Prof-Syaef/ExFaBox_IoT/README.md

# ExFaBox_IoT
Perangkat sistem monitoring temperature dan humidity yang memiliki data logger menggunakan MicroSD serta dapat melakukan action untuk menjaga temperature dan humidity menggunakan fan dengan 2 swtihing relay.
