Prof-Syaef/ExFaBox_IoT/ExFaBox_V1/Eksport skematik EDUTIC_SMART_MONITORING_IOT_V1.0.pdf

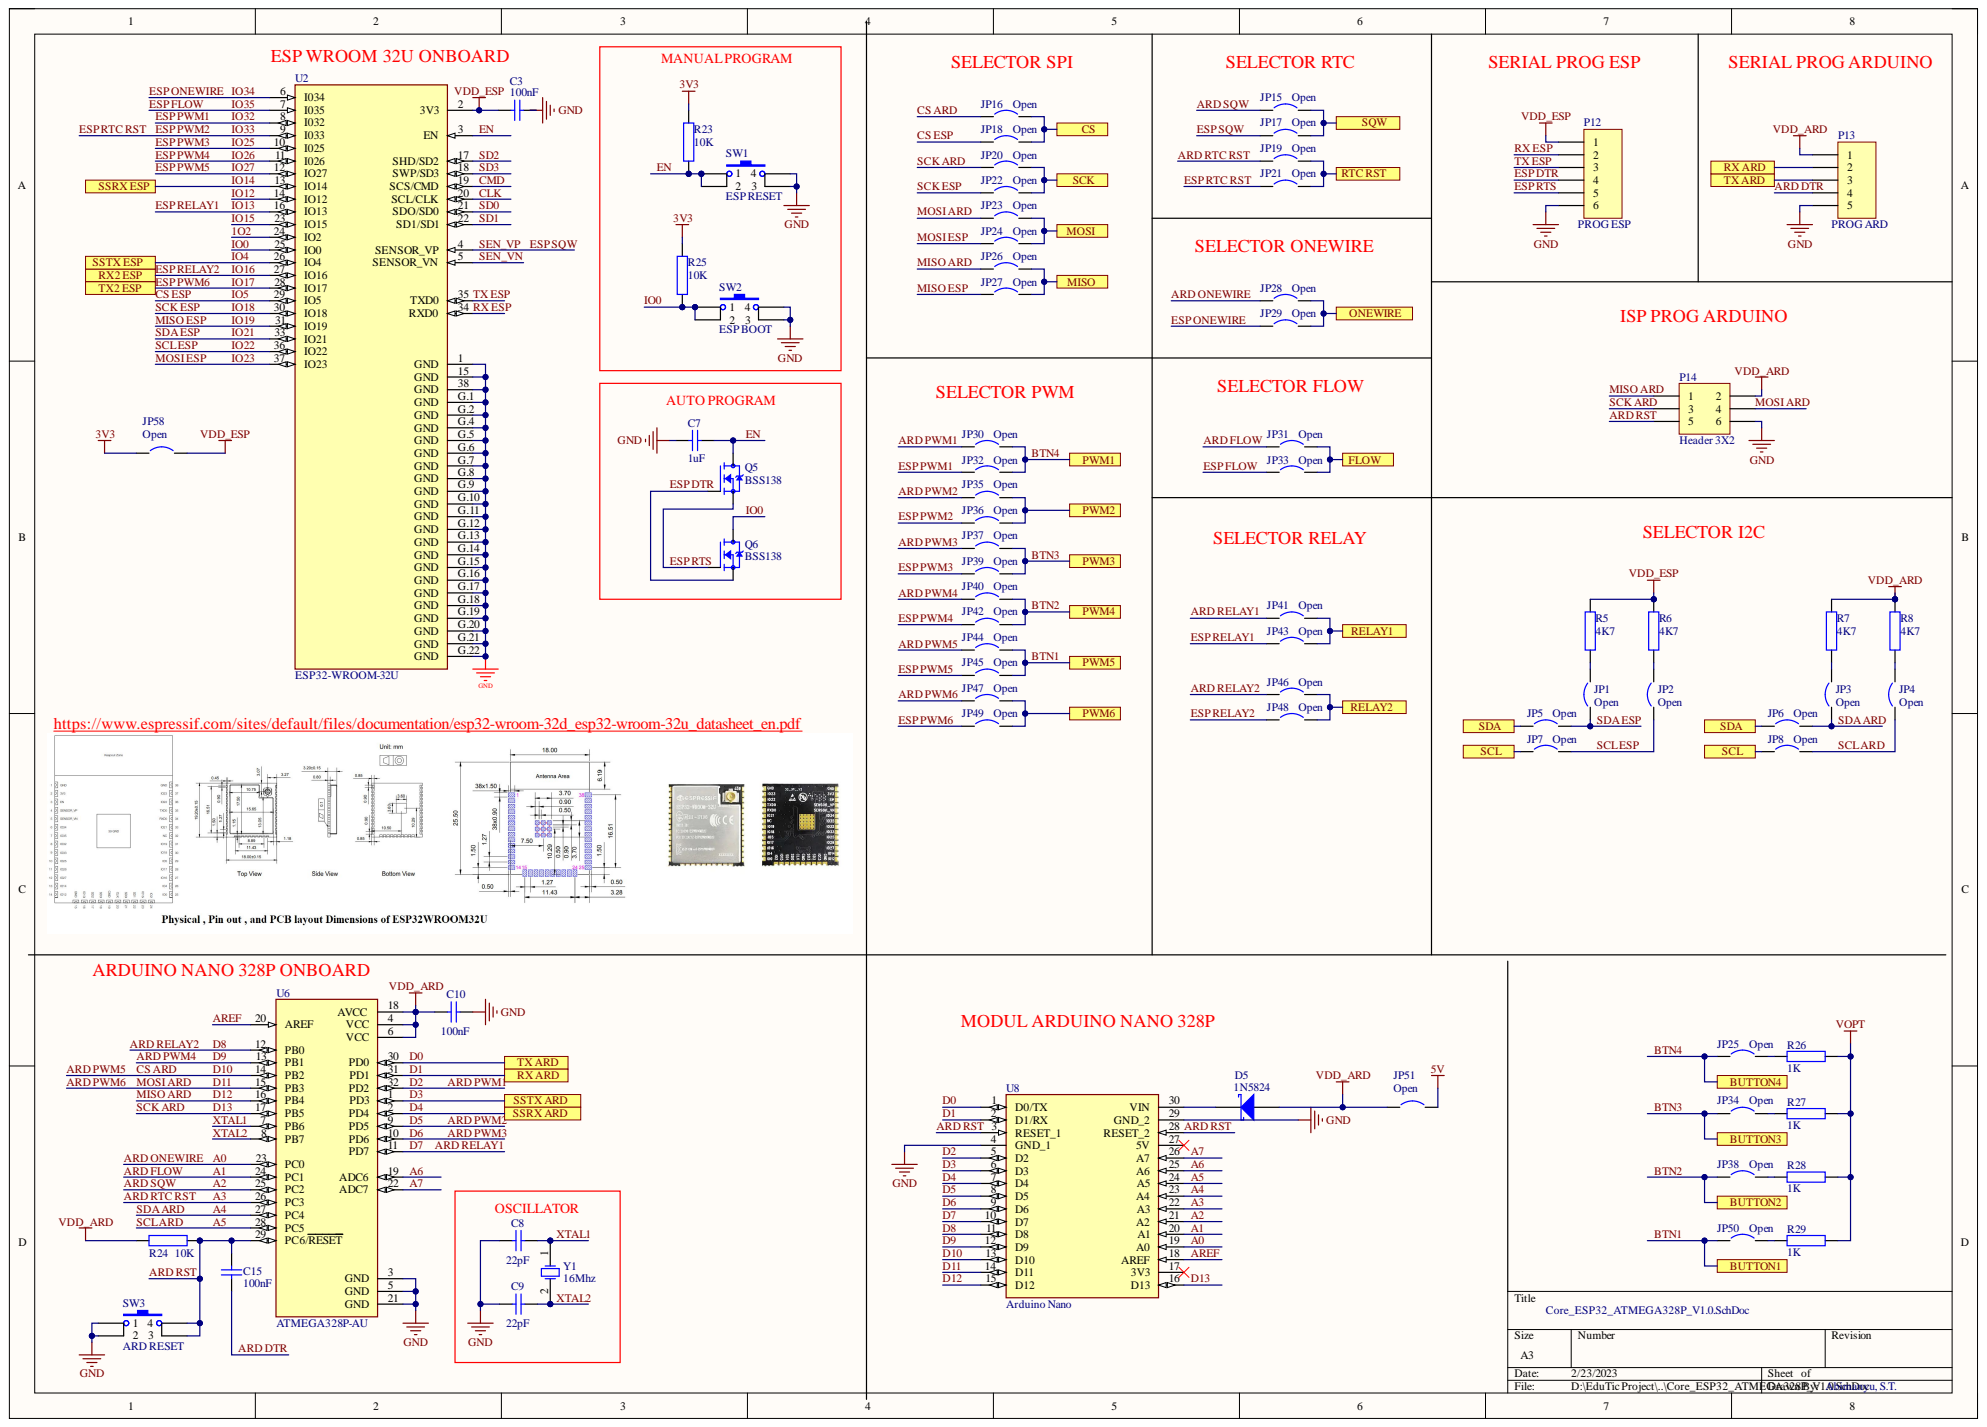
[picture p1: page 1]

RX2 ESP | ESPRELAY2 IO16 | IO16 27 | TX ESP

https://www.espressif.com/sites/default/files/documentation/esp32-wroom-32d_esp32-wroom-32u_datasheet_en.pdf

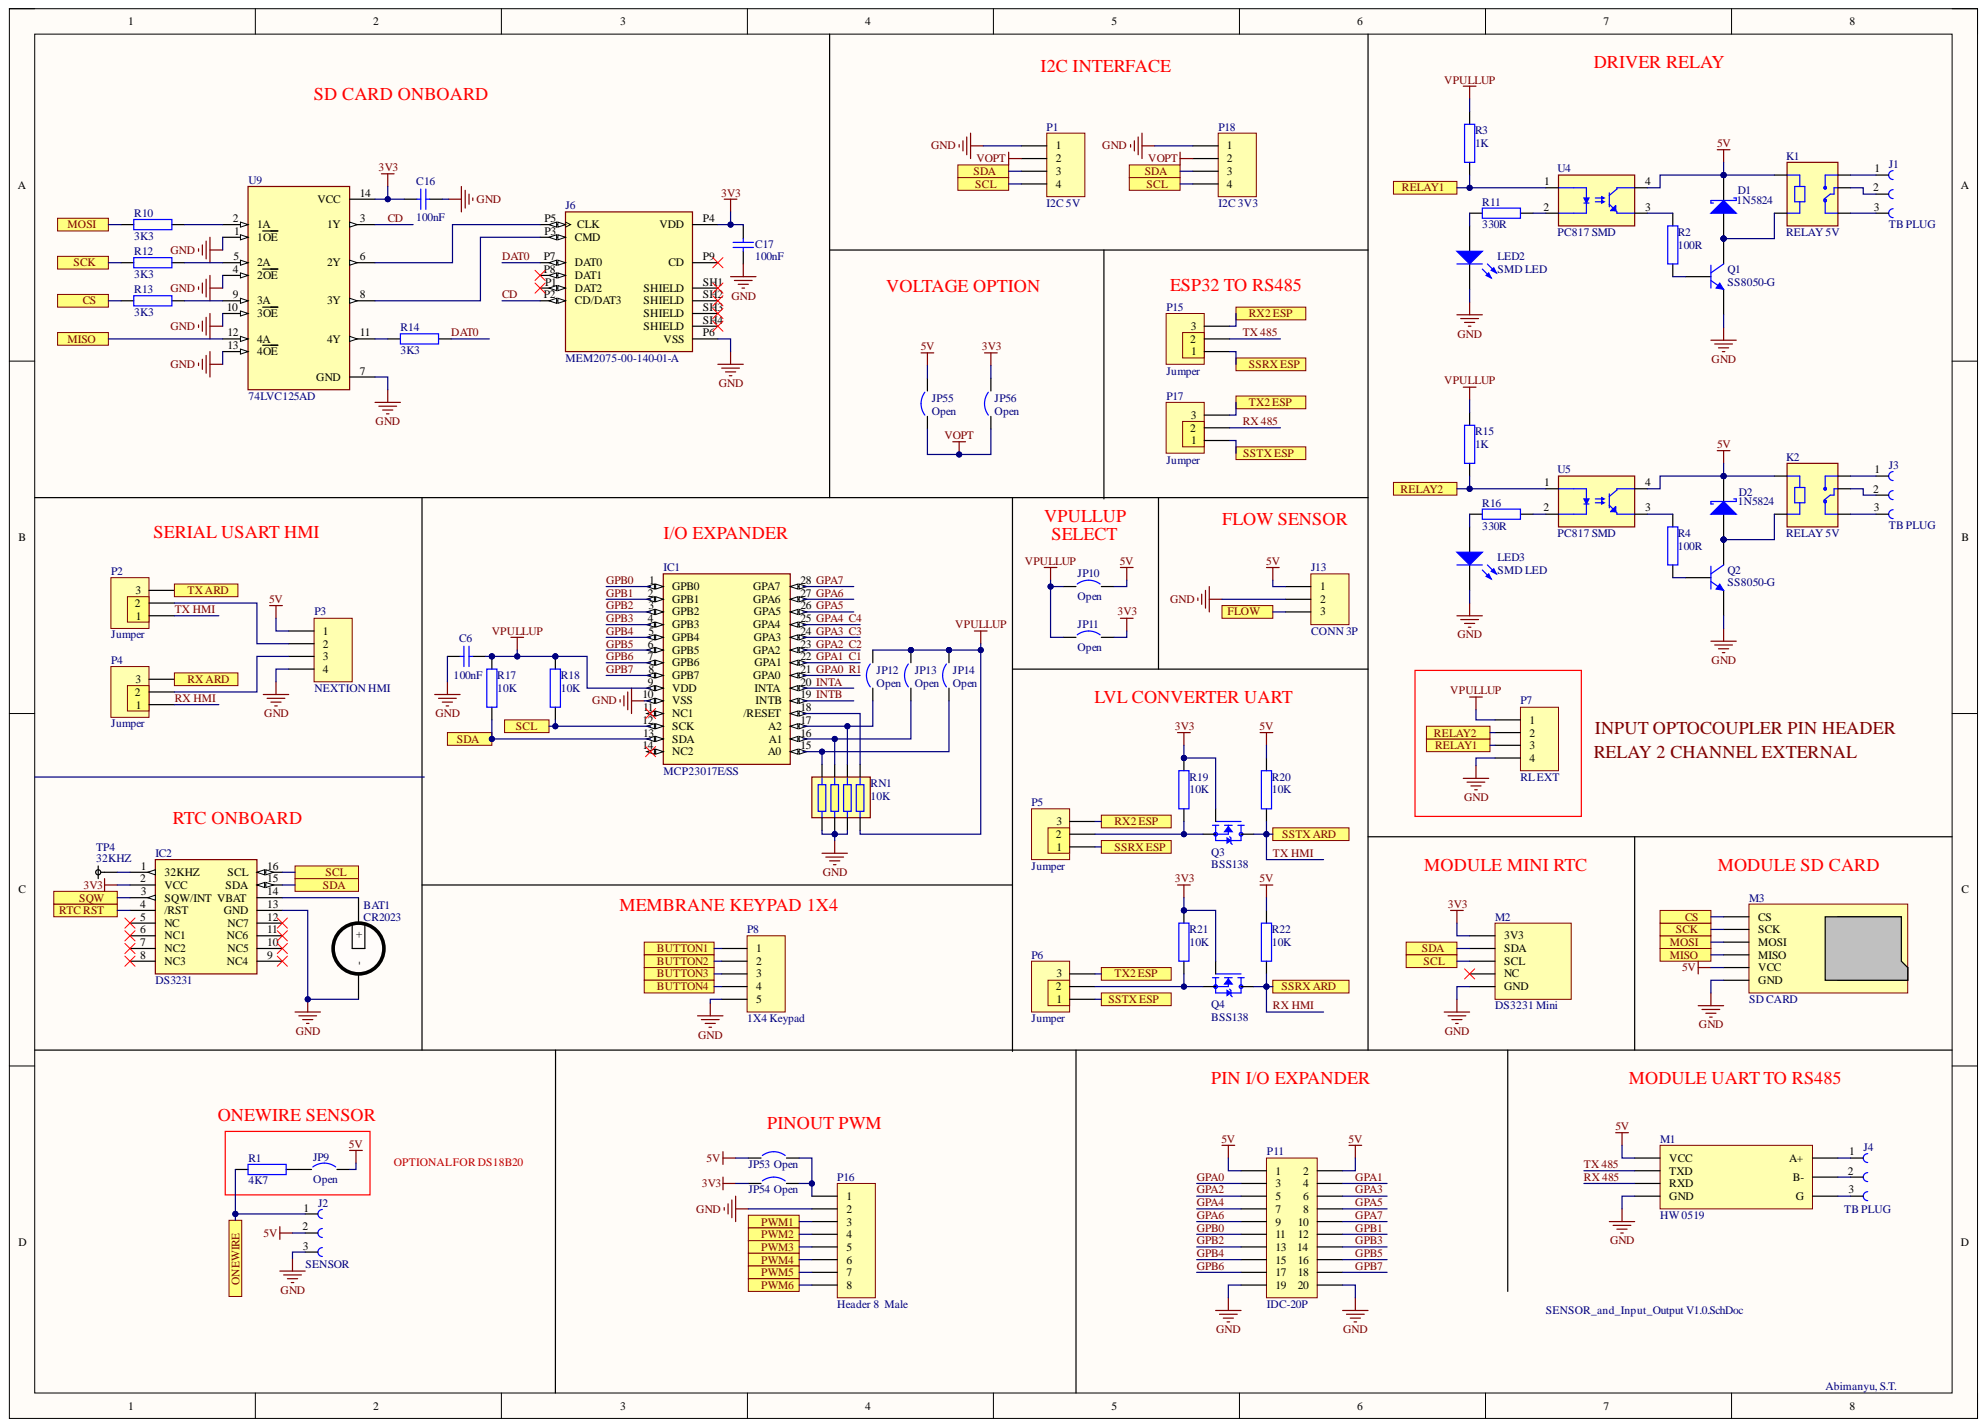
[picture p2: page 2]

2 1 | 3V3 | | SSTX ARD

SSRX ESP | BSS138 | TX HMI

SQW | /RST 4

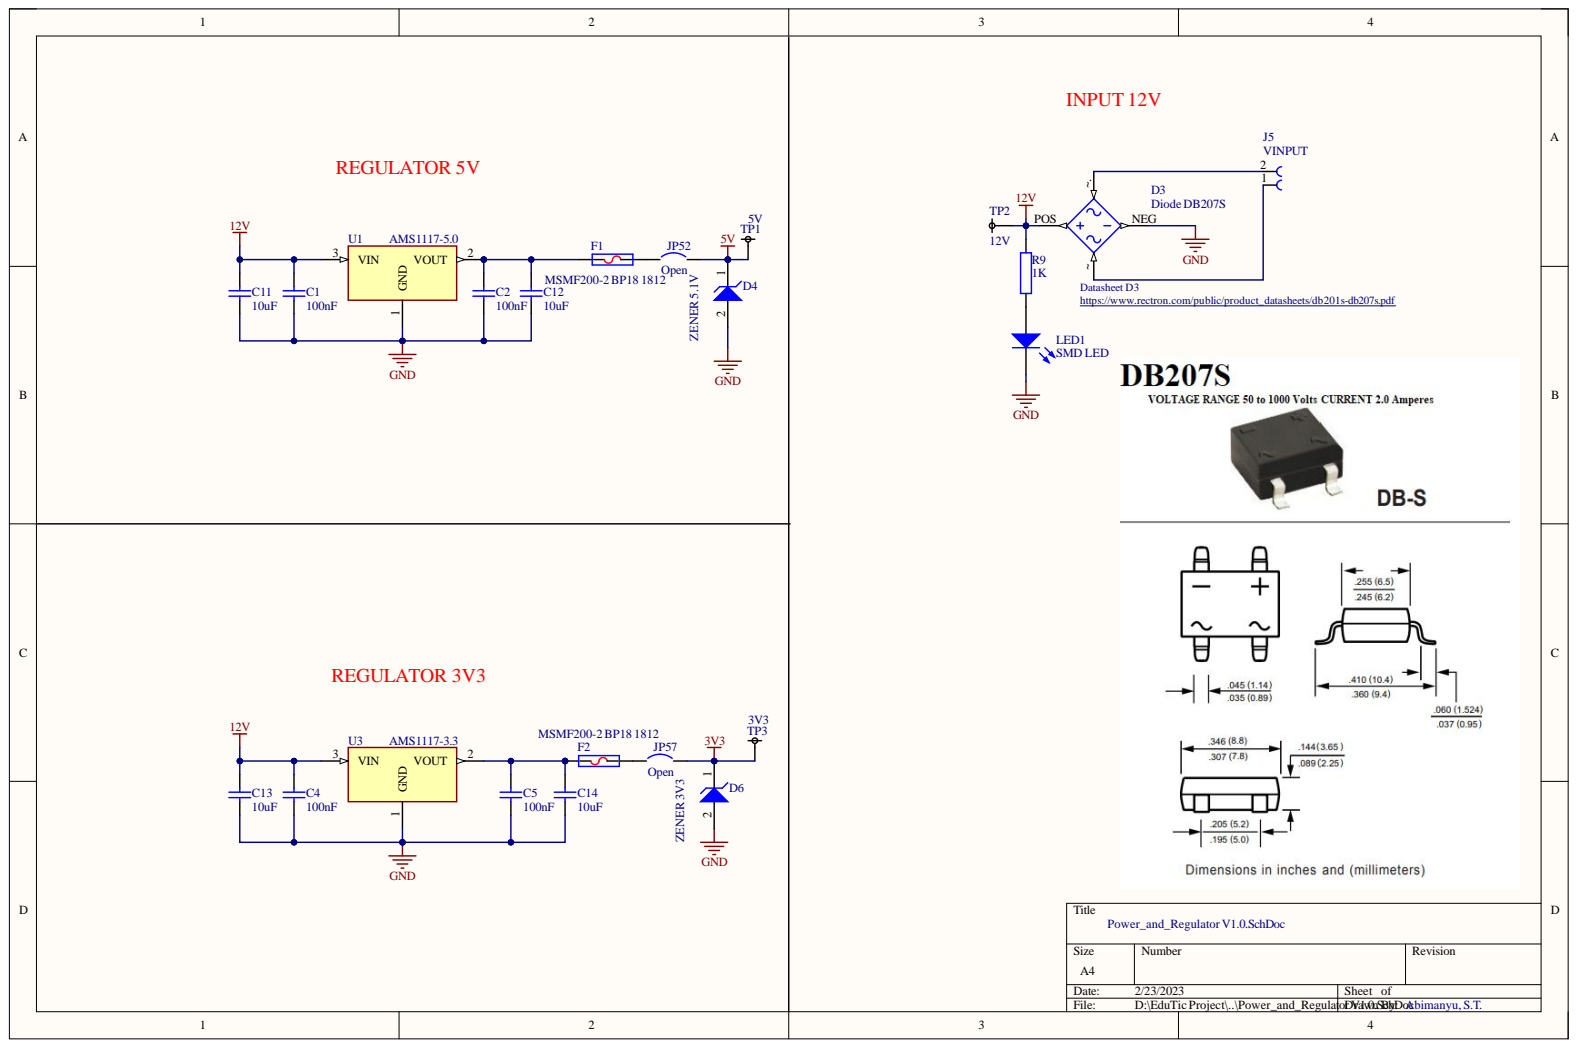
[picture p3: page 3]

https://www.rectron.com/public/product_datasheets/db201s-db207s.pdf

Size A4 | Number | Revision

Date: 2/23/2023 | Sheet of
File: D:\EduTic Project\..\Power_and_RegulatoDr r Va1wn .0.SBchy:Doc | Abimanyu, S.T.

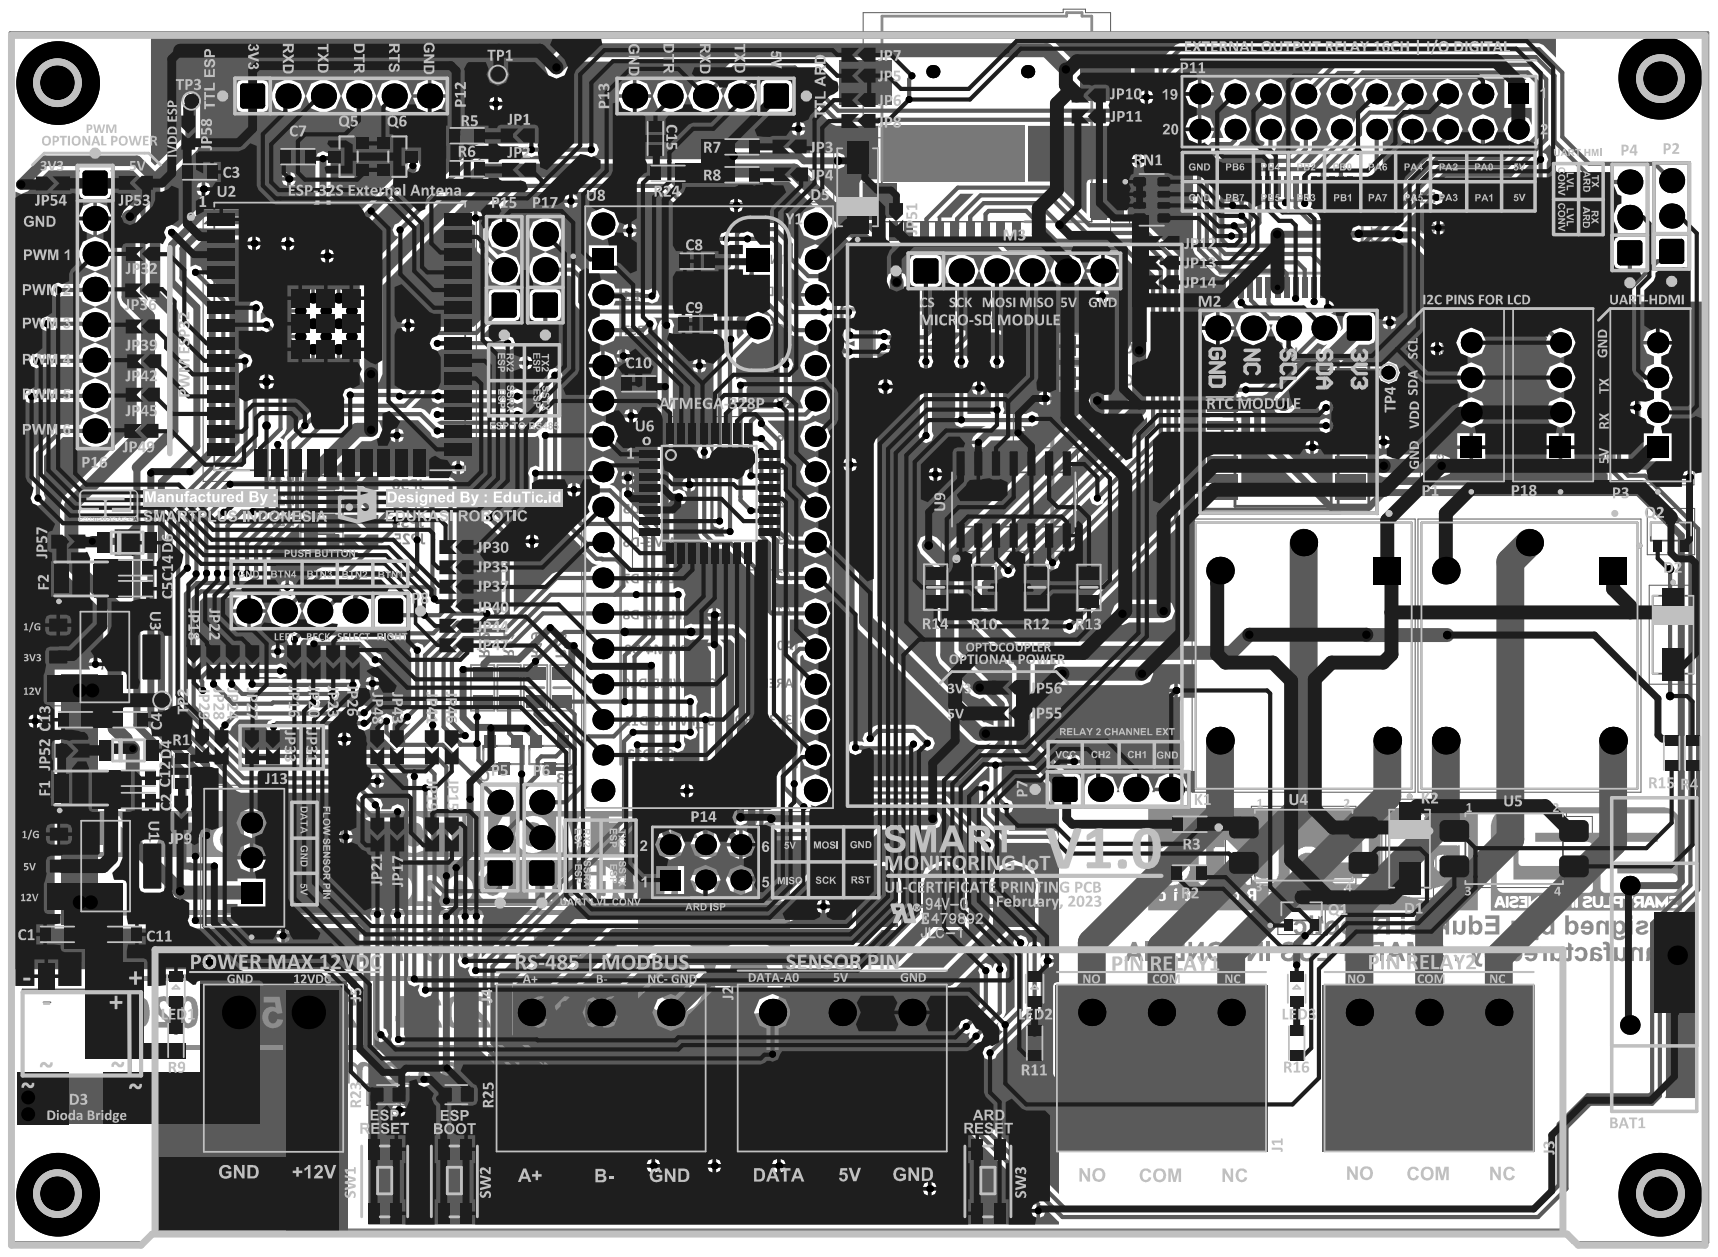
[picture p4: page 4]

Comment | Description | Designator | Footprint | LibRef | Quantity
CR2023 | BATTERY HOLDER | BAT1 | BATT CR2023
| | | VERTICAL | BATT CR2023
VERTICAL | 1
100nF | 0805 SMD Non-Polarity Capacitor, 1206 SMD Non-Polarity Capacitor | C1, C2, C3, C4, C5, C10, C15 | 1608_[0603] Capacitor | Capacitor 0805 (Inch), Capacitor 1206 (Inch) | | 7
100nF | 0805 SMD Non-Polarity Capacitor | C6, C16, C17 | CAP-0805_Capacitor Non Polar | Capacitor 0805 (Inch) | | 3
1uF | 0805 SMD Non-Polarity Capacitor | C7 | 1608_[0603] Capacitor | Capacitor 0805 (Inch) | | 1
22pF | 1206 SMD Non-Polarity Capacitor | C8, C9 | 1608_[0603] Capacitor | Capacitor 1206 (Inch) | | 2
10uF | 0805 SMD Non-Polarity Capacitor | C11, C12, C13, C14 | 1608_[0603] Capacitor | Capacitor 0805 (Inch) | | 4
1N5824 | Maximum repetitive peak reverse voltage 40v Maximum average forward rectified current 5.0A Peak forward surge current 8.3mS 100A Voltage rate of change 10000 V/uS Operating junction temperature range -55 to +150 C | D1, D2, D5 | DO-214AC | 1N5824 SMD | | 3
Diode DB207S | Bridge Rectifier Single Phase Standard 1kV 2A Surface Mount DB-S | D3 | SOP 4 - Dioda Bridge -duplicate | Diode DB207S | | 1
ZENER 5.1V | Zener Diodes 4.7V 200mW | D4 | SOD-80C | Diode Zener 2 | | 1
ZENER 3V3 | Zener Diodes 4.7V 200mW | D6 | SOD-80C | Diode Zener 2 | | 1
1210 | PTC RESET FUSE 8V 2A | F1, F2 | 1206_Fuse | PTC RESET FUSE | | 2
MCP23017E/SS | I/O Expander 16 IÂ²C 10MHz 28-SSOP | IC1 | SSOP-28 | MCP23017E/SS | | 1
DS3231 | Real Time Clock (RTC) IC Clock/Calendar -IÂ²C, 2-Wire Serial 8-SOIC (0.154, 3.90mm Width) | IC2 | SOIC-16 | DS3231 | | 1
TB PLUG | TB PLUG 3P 5M | J1, J3, J4 | TB PLUG 3P 5mm | TB PLUG 3P 5M | | 3
SENSOR | TB PLUG 3P 5M | J2 | TB PLUG 3P 5mm | TB PLUG 3P 5M | | 1
VINPUT | 2 Position Terminal Block Header, Male Pins, Shrouded (2 Side) 0.197 (5.00mm) 90Â°, Right Angle -Through Hole | J5 | TERMINAL BLOCK PLUG 2P 5MM | TERMINAL BLOCK PLUG 2P 5MM | | 1
MEM2075-00-140-01-A | Micro SD Memory Card Connector, 1.4mm Profile SMT, Push-Push, with Normally open Switch | J6 | GCT_MEM2075-00-140-01-A | MEM2075-00-140-01-A | | 1
CONN 3P | Connector Header Through Hole 3 position 0.098 (2.50mm) | J13 | CONN HDR 3P TH | CONN HDR 3P TH | | 1
Open | Jumper Solder Pad | JP1, JP2, JP3, JP4, JP5, JP6, JP7, JP8, JP9, JP10, JP11, JP12, JP13, JP14, JP15, JP16, JP17, JP18, JP19, JP20, JP21, JP22, JP23, JP24, JP25, JP26, JP27, JP28, JP29, JP30, JP31, JP32, JP33, JP34, JP35, JP36, JP37, JP38, JP39, JP40, JP41, JP42, JP43, JP44, JP45, JP46, JP47, JP48, JP49, JP50, JP51, JP52, JP53, JP54, JP55, JP56, JP57, JP58 | SB_STM | Jumper Solder | 58
RELAY 5V | 5V Trigger Relay Module For Arduino And Raspberry Pi 5V Trigger Relay Module For Arduino And Raspberry Pi | K1, K2 | RELAY_SONGLE-05VDC-SL-C | RELAY SONGLE 5V | | 2
SMD LED | 0603 RED LED, 0603 BLUE LED | LED1, LED2, LED3 | LED SMT 1608 (0603) | LED SMT RED, LED SMT BLUE | | 3
HW 0519 | RS485 TO UART | M1 | HW 0519 | HW 0519 | | 1
DS3231 Mini | Mini RTC | M2 | Module DS3231 Mini RTC RIVERSED | Module RIVERSED DS3231 Mini RTC for Pi | | 1
SD CARD | Module SD CARD | M3 | MODULE SD CARD | Module SD CARD | | 1
I2C 5V | CONN HEADER 4P TH | P1 | CONN HDR 4P TH | CONN HDR 4P TH | | 1
Jumper | Jumper Pin, 3-Pin | P2, P4, P5, P6, P15, P17 | Jumper Pin, 3-Pin | Jumper Pin, 3-Pin | | 6
NEXTION HMI | CONN HEADER 4P TH | P3 | CONN HDR 4P TH | CONN HDR 4P TH | | 1
RL EXT | Header, 4-Pin | P7 | Pin Header 1x4 TH Pitch 2.54mm | Header 4 Male | | 1
1X4 Keypad | Header, 5-Pin | P8 | Pin Header 1x5 TH Pitch 2.54mm | Header 5 Male | | 1
IDC-20P | IDC-20P | P11 | IDC-20P | IDC-20P | | 1
PROG ESP | Header, 6-Pin | P12 | Pin Header 1x6 TH Pitch 2.54mm | Header 6 Male | | 1
PROG ARD | Header, 5-Pin | P13 | Pin Header 1x5 TH Pitch 2.54mm | Header 5 Male | | 1
Header 3X2 | Header, 3-Pin, Dual row | P14 | HEADER 2X3 | Header 3X2 | | 1
Header 8 Male | Header, 8-Pin | P16 | Pin Header 1x8 TH Pitch 2.54mm | Header 8 Male | | 1
I2C 3V3 | CONN HEADER 4P TH | P18 | CONN HDR 4P TH | CONN HDR 4P TH | | 1
SS8050-G | Bipolar (BJT) Transistor NPN 25 V 1.5 A 100MHz 300mW Surface Mount SOT-23-3 | Q1, Q2 | TO-236 | TR SS8050-G | | 2
BSS138 | N-CH MOSFET 50V 0.34A SOT-23-3L | Q3, Q4, Q5, Q6 | SOT-23 | BSS138 | | 4
4K7 | 0805 SMD Thick Resistor, 1206 SMD Thick Resistor | R1, R5, R6, R7, R8 | 1608_[0603] Resistor | Resistor 0805 (Inch), Resistor 1206 (Inch) | | 5
100R | 1206 SMD Thick Resistor | R2, R4 | 1608_[0603] Resistor | Resistor 1206 (Inch) | | 2
1K | 1206 SMD Thick Resistor, 0805 SMD Thick Resistor | R3, R9, R15 | 1608_[0603] Resistor | Resistor 1206 (Inch), Resistor 0805 (Inch) | | 3
3K3 | 0805 SMD Thick Resistor | R10, R12, R13, R14 | RESITOR 0805 | Resistor 0805 (Inch) | | 4
330R | 1206 SMD Thick Resistor | R11, R16 | 1608_[0603] Resistor | Resistor 1206 (Inch) | | 2
10K | 0805 SMD Thick Resistor | R17, R18, R19, R20, R21, R22 | RESITOR 0805 | Resistor 0805 (Inch) | | 6
10K | 0805 SMD Thick Resistor | R23, R25 | RESISTOR 0603 | Resistor 0805 (Inch) | | 2
10K | 1206 SMD Thick Resistor | R24 | 1608_[0603] Resistor | Resistor 1206 (Inch) | | 1
1K | 0603 SMD Thick Resistor | R26, R27, R28, R29 | RESISTOR 0603 | Resistor 0603 (Inch) | | 4
10K | Resistor Array, Chip, 4 elements CONVEX 1206 2% | RN1 | RES 4ARR 0603 | RES 4ARR 0603 | | 1
ESP RESET | Switch | SW1 | SW-TACT SMT | SW-TACT-SMT | | 1
ESP BOOT | Switch | SW2 | SW-TACT SMT | SW-TACT-SMT | | 1
ARD RESET | Switch | SW3 | SW-TACT SMT | SW-TACT-SMT | | 1
5V | Thick Pad | TP1 | PAD | Test Point | | 1
12V | Thick Pad | TP2 | PAD | Test Point | | 1
3V3 | Thick Pad | TP3 | PAD | Test Point | | 1
32KHZ | Thick Pad | TP4 | PAD_HOLE | Test Point | | 1
AMS1117-5.0 | | U1 | SOT-223 | AMS1117-5.0 | | 1
ESP32-WROOM-32U | Wi-Fi/BT BLE Module ESP32-D0WD SPI Flash UART U.FL Conn. | U2 | ESP32-WROOM-32U | ESP32-WROOM-32U | | 1
AMS1117-3.3 | | U3 | SOT-223 | AMS1117-3.3 | | 1
PC817 SMD | Optoisolator Transistor Output 1 Channel 4-DIP | U4, U5 | SMD-4 | PC817 SMD | | 2
ATMEGA328P-AU | AVR AVRÂ® ATmega Microcontroller IC 8-Bit 20MHz 32KB (16K x 16) FLASH 32-TQFP (7x7) | U6 | TQFP-32 | ATMEGA328P-AU | | 1
Arduino Nano | Small, complete, and breadboard-friendly board based on the ATmega328 (Arduino Nano 3.x). | U8 | ARDUINO NANO | Arduino Nano | | 1
74LVC125AD | Buffer/Line Driver 4-CH Non-Inverting 3-ST CMOS 14-Pin SO | U9 | SOIC14 | 74LVC125AD | | 1
16Mhz | Crystal Oscillator | Y1 | X TAL | XTAL | | 1
