Prof-Syaef/ExFaBox_IoT/(commit log)

2023-05-22 ExFaBoxV1.0_Arduino
    Program ini digunakan untuk perangkat ExFaBoxV1.0 dengan Chip ATMega328P (arduino nano) belum ada sistem monitoring IoT
2023-05-22 ADD SCHEMATIC DESIGN
    Masih ada yang revisi D3 Tidak di gunakan, Jadi power input langsung dari Stepdown outputnya 5.9VDC, karena ada dioda yang drop tegangan hingga 0.7V
